DitroniX/EPEM-Ethernet-Power-Energy-Monitor/Code/README.md

# ** EPEM **

This folder contains Example Source Code and Information to help you develop and experiment, using the **EPEM Ethernet Power Energy Monitor** board.

  The purpose of the test code is to cycle through the various main functions of the board, as part of board bring up testing and product learning.
 
The **EPEM** is **ESP32-C6** based and the following examples/information should help you get started.

# FLEX and Home Assistant (ESPHome)

**FLEX** is PlatformIO code which tests and runs on either the EPEM ATM90E32 or EPEM ATM90E326.

[FLEX can be found here](https://github.com/DitroniX/EPEM-Ethernet-Power-Energy-Monitor/tree/main/Code/PlatformIO)

**Home Assistant (ESPHome)** support is also provided.

[Additional Home Assistant (ESPHome), component repository can be found here](https://github.com/DitroniX/Home-Assistant-Dev)

# Example Environments

## * **Arduino IDE**

The Arduino IDE does not auto detect and allows you to manually set the board

Set the BOARD to any **ESP32-C6**.  Example board options include:

 1. Adafruit Feather ESP32-C6
 2. DFRobot Beetle ESP32-C6

Arduino libraries specific for the code examples may need adding to your installation, as these are not automatically installed, unlike PlatformIO.

## * **PlatformIO**

When using PlatformIO code, the file *platformio.ini* should automatically load required libraries and configure board.   

The below example in *platfomio.ini* will configure the ESP32-C6.

	 - [env:esp32-c6-devkitm-1] 
	 - platform = espressif32 
	 - board = esp32-c6-devkitm-1 
	 - framework = arduino

Example PlatformIO will have the configuration set and libraries included, so this makes it easier.  Any libraries not installed, will automatically install.

## * **ESPHome**

In ESPHome you configure the board in the *yaml* code.

ESPHome unfortunately for some reason, does not list support for the ESP32-C6 within the code but it does work

In the later release of Home Assistant, this ESP32-C6 has native support.

The below example will configure the ESP32-C6.

	  - board: esp32-c6-devkitm-1
	  - flash_size: 4MB
	  - framework: type: esp-idf
	  - sdkconfig_options: CONFIG_ESPTOOLPY_FLASHSIZE_4MB: y

## * **Tasmota**

In Tasmota, you can:

	  -  set a template based on ESP32-C6

## * **MicroPython**

To flash, or program, a board in [MicroPython](https://micropython.org/download/ESP32_GENERIC_C6/), you will use the the esptool.py program. 

Details can be found [here] (https://docs.espressif.com/projects/esptool/en/latest/esp32c6/)

## * **LabVIEW**
This section is work in progress but with a focus on integrating the ESPuno Pi Zero, into the LabVIEW environment for training and experimenting.

The tutorial examples will be based on using LabVIEW Community Edition (which is free for non-commercial use).

## * **ThingSpeak**
[**ThingSpeak**](https://thingspeak.mathworks.com/) is a cloud base service.  It is free for small IoT Projects.

ThingSpeak (free version), offers up to four channels, each with 8 fields.   It is easy to setup and use, such as from IoT devices.

Data can be easily displayed on the web, mobile or tablets.  These consist of Graphs, Dials, Numeric and Lamp.

**Example Data**

Example output can be seen [here](https://thingspeak.mathworks.com/channels/2943970) 

Other Public Channels can be found [here](https://thingspeak.mathworks.com/channels/public)

# Flashing Speeds and Power

  - You may set the BAUD rate to 921600 to speed up flashing.
  - The SDK does NOT need external power to flash and will take Power from the USB 5V.

# Example Code

This test code is OPEN SOURCE and formatted for easier viewing.  

Although is is not intended for real world use, it may be freely used, or modified as needed to get your project up and running.

It is distributed on an "AS IS" BASIS, WITHOUT WARRANTIES OR CONDITIONS OF ANY KIND, either express or implied.

# **Further Information**

Additional information, and other technical details on this project, maybe found in the related repository pages.

**Repository Folders**

 - **Code** *(Code examples for Arduino  IDE, PlatformIO, ESPHome, Tasmota)*
 -  **Datasheets and Information** *(Component Datasheets, Schematics, Board Layouts, Photos, Technical Documentation)*
 - **Certification** *(Related Repository Project or Part, Certification Information)*

**Repository Tabs**

 - **Wiki** *(Related Repository Wiki pages and Technical User Information)*
 - **Discussions** *(Related Repository User Discussion Forum)*
 - **Issues** *(Related Repository Technical Issues and Fixes)*

***

We value our Customers, Users of our designs and STEM Communities, all over the World . Should you have any other questions, or feedback to share to others, please feel free to:

* Visit the related [Project](https://github.com/DitroniX?tab=repositories) *plus the related* **Discussions** and **Wiki** Pages.  See tab in each separate repository.
* **Project Community Information** can be found at https://www.hackster.io/DitroniX
* [DitroniX.net Website - Contact Us](https://ditronix.net/contact/)
* **Twitter**: [https://twitter.com/DitroniX](https://twitter.com/DitroniX)
* [Supporting the STEM Projects - BuyMeACoffee](https://www.buymeacoffee.com/DitroniX)
*  **LinkedIN**: [https://www.linkedin.com/in/g8puo/](https://www.linkedin.com/in/g8puo/)

***Dave Williams, Maidstone, UK.***

Electronics Engineer | Software Developer | R&D Support | RF Engineering | Product Certification and Testing | STEM Ambassador

## STEM

**Supporting [STEM Learning](https://www.stem.org.uk/)**

Life is one long exciting learning curve, help others by setting the seed to knowledge.
