DitroniX/EPEM-Ethernet-Power-Energy-Monitor/Datasheets and Information/README.md

**EPEM ESP32 ATM90E32 ATM90E36 Ethernet Power Energy Monitor SDK**

------------

This folder contains applicable datasheets and EPEM design information.

Further information can be found:

- **Website** https://ditronix.net/
- **WIKI**  https://ditronix.net/wiki/
- **GitHub**  https://github.com/DitroniX/

Dave Williams | G8PUO | DitroniX 1981-2025 | ditronix.net
