DitroniX/EPEM-Ethernet-Power-Energy-Monitor/Code/PlatformIO/README.md

**EPEM ESP32-C6 ATM90E36 Ethernet Power Energy Monitor SDK**

Please also see the [FLeX Test Code](https://github.com/DitroniX/FLEX-DitroniX-Power-Energy-Monitor-Firmware)

------------

This folder contains Example Source Code and Information to help you develop and experiment, using the EPEM Example Source Code.

For configuration information, please see README in root of the GitHub Code folder.
