DitroniX/EPEM-Ethernet-Power-Energy-Monitor/Certification/_CCAF25Y10610T3.pdf

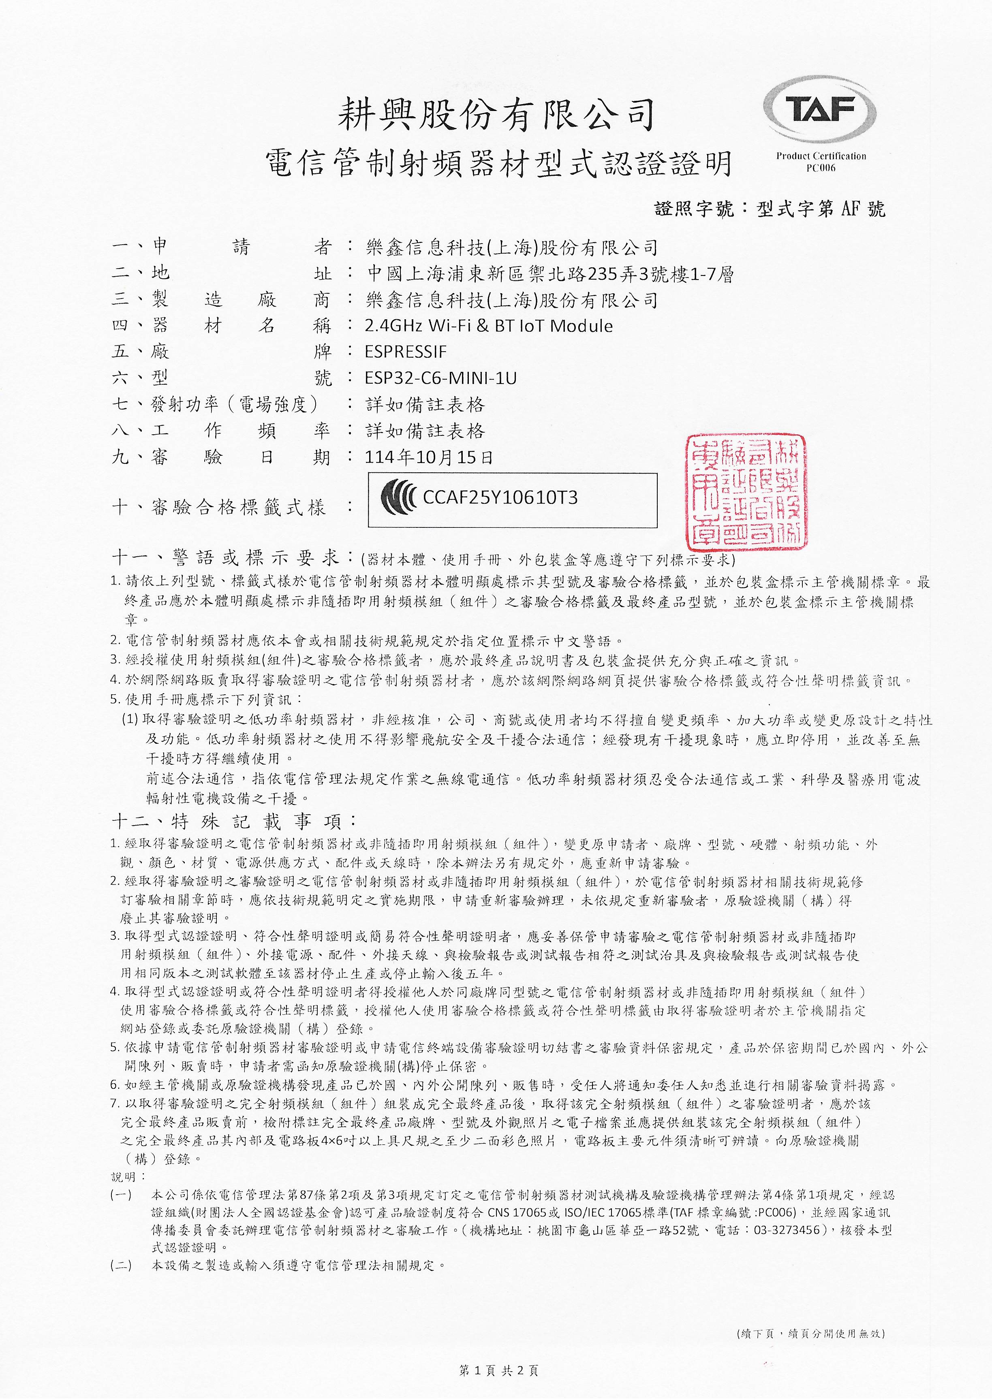
[picture p6: page 1]
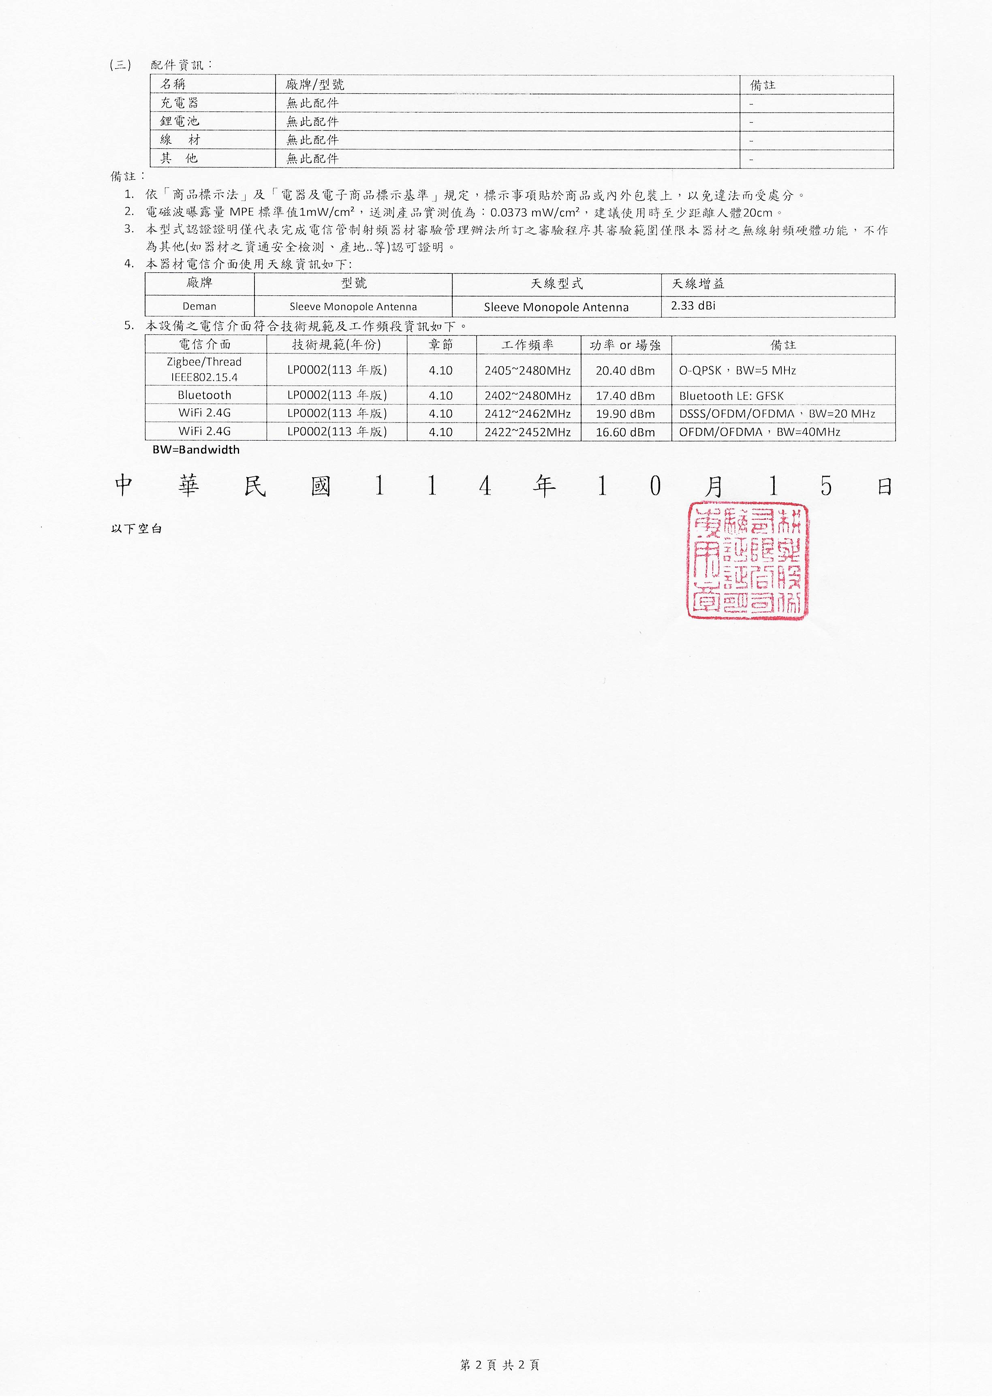
[picture p7: page 2]
