DitroniX/EPEM-Ethernet-Power-Energy-Monitor/Code/HomeAssistant-ESPHome/EPEM Ethernet Example/Screenshot.png

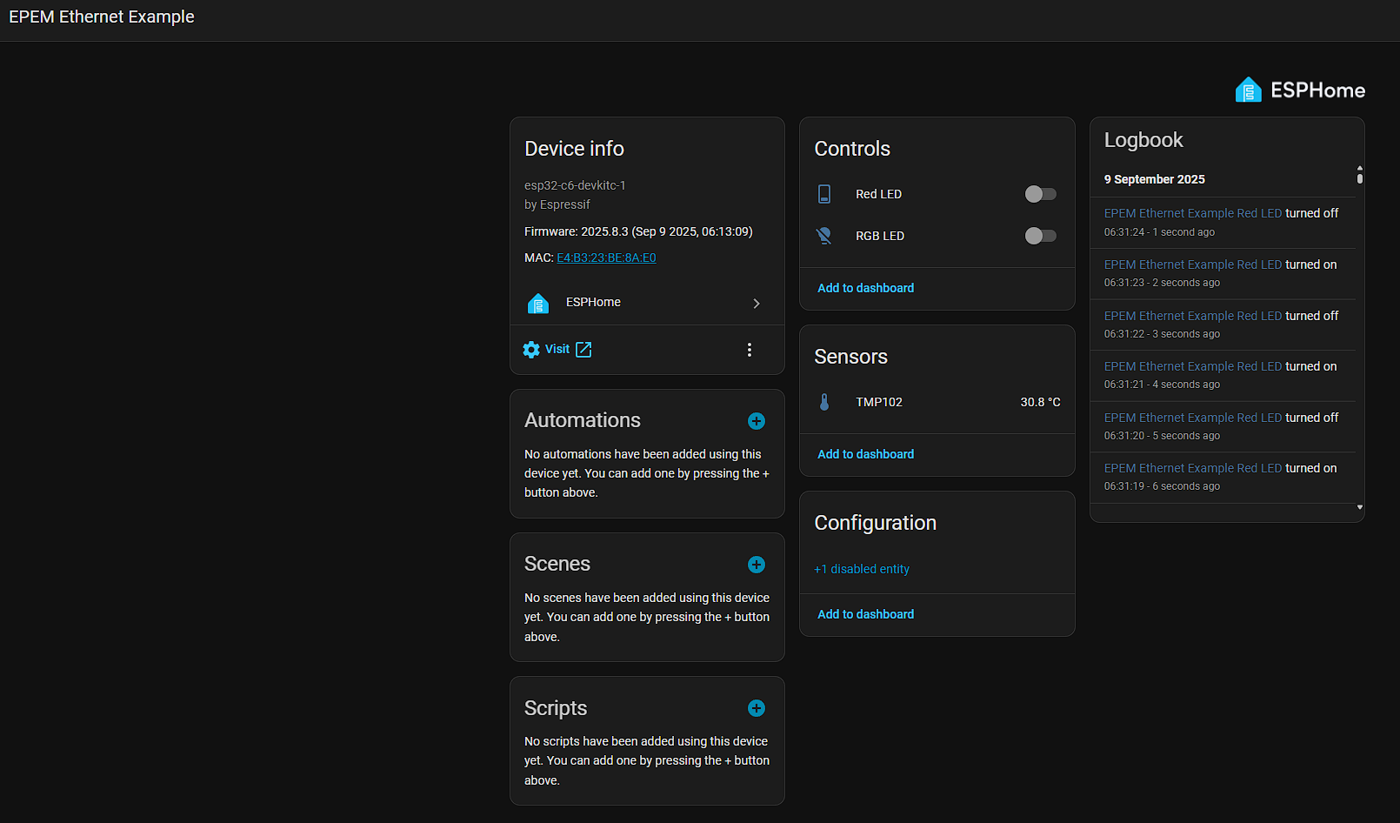
Code/HomeAssistant-ESPHome/EPEM Ethernet Example/Screenshot.png
