DitroniX/EPEM-Ethernet-Power-Energy-Monitor/Code/HomeAssistant-ESPHome/EPEM OLED Example/EPEM OLED.jpg

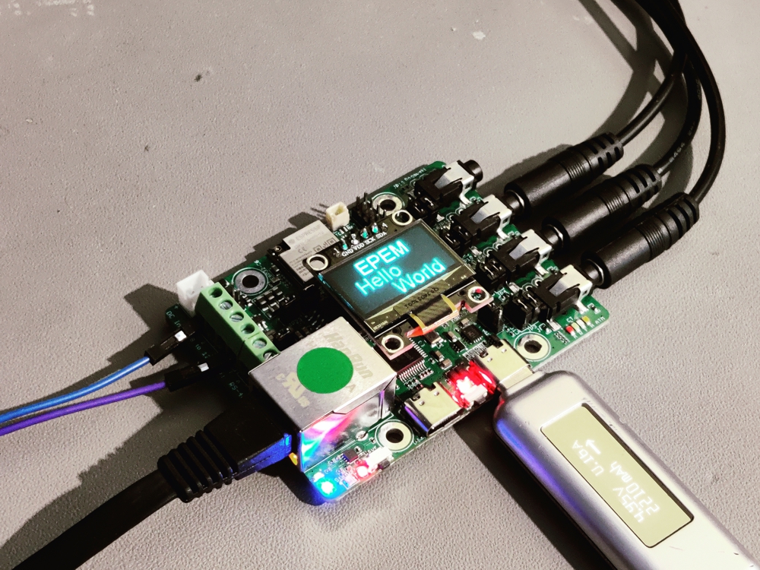
Code/HomeAssistant-ESPHome/EPEM OLED Example/EPEM OLED.jpg
