DitroniX/EPEM-Ethernet-Power-Energy-Monitor/Datasheets and Information/ATM90E32A Block Diagram.png

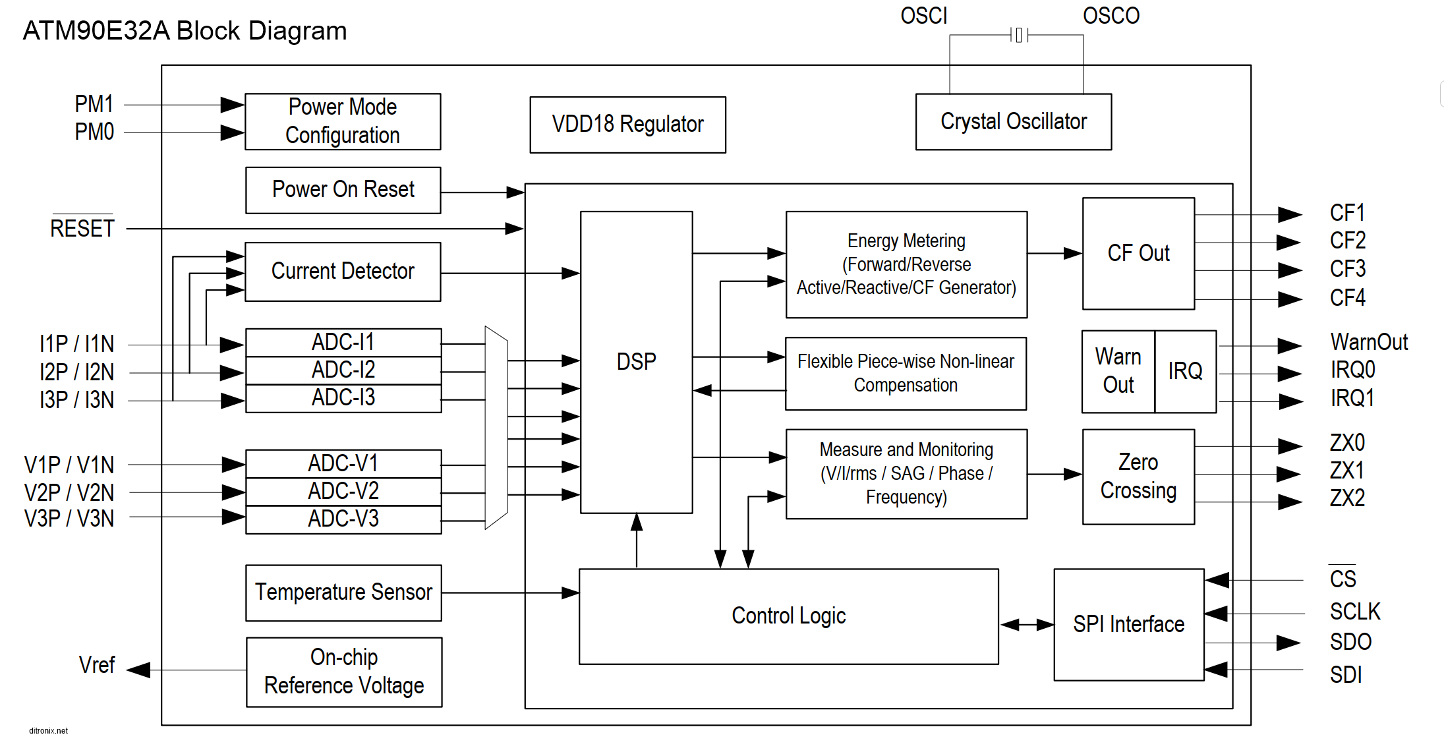
Datasheets and Information/ATM90E32A Block Diagram.png
