DitroniX/EPEM-Ethernet-Power-Energy-Monitor/Datasheets and Information/ATM90E36A Block Diagram.png

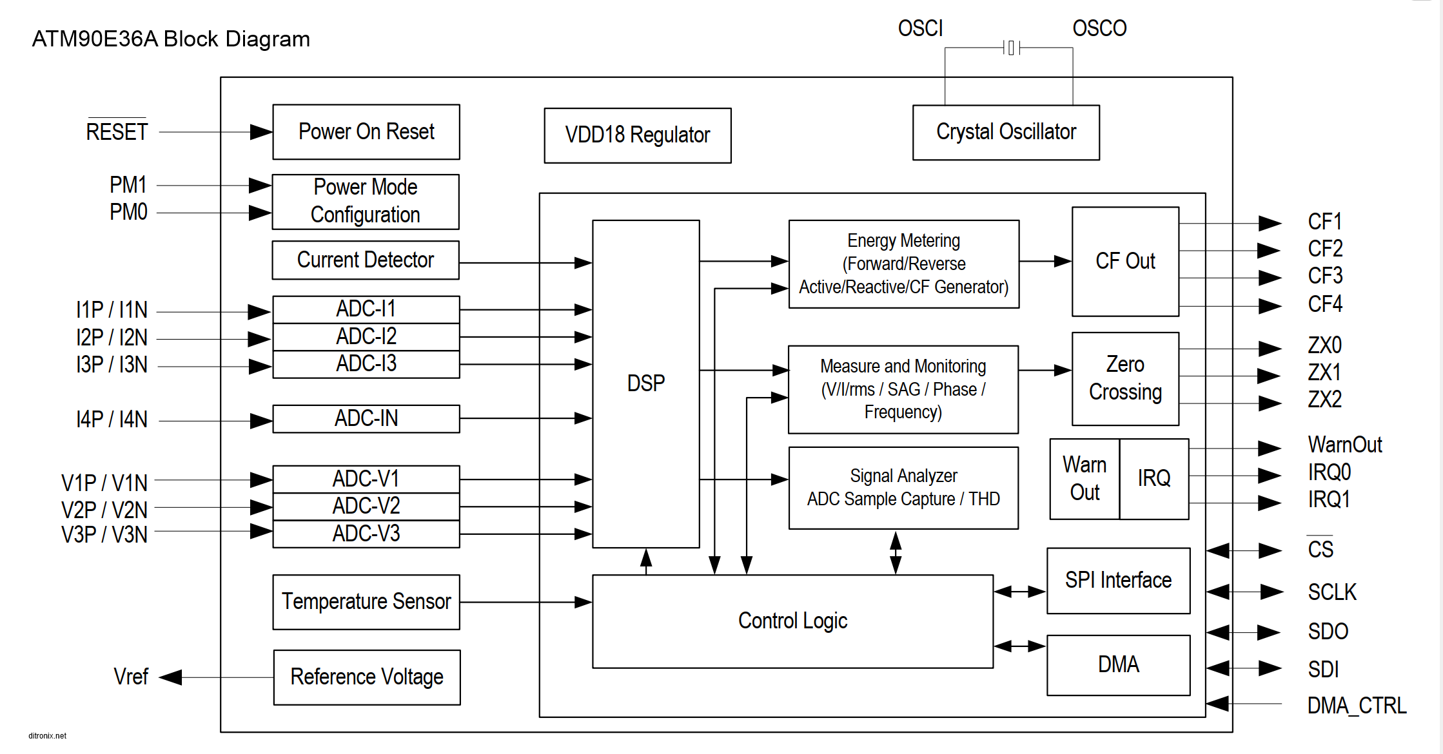
Datasheets and Information/ATM90E36A Block Diagram.png
