DitroniX/EPEM-Ethernet-Power-Energy-Monitor/Datasheets and Information/DitroniX.net EPEM Ethernet Power Energy Monitor Board SDK AC-CT Inputs.png

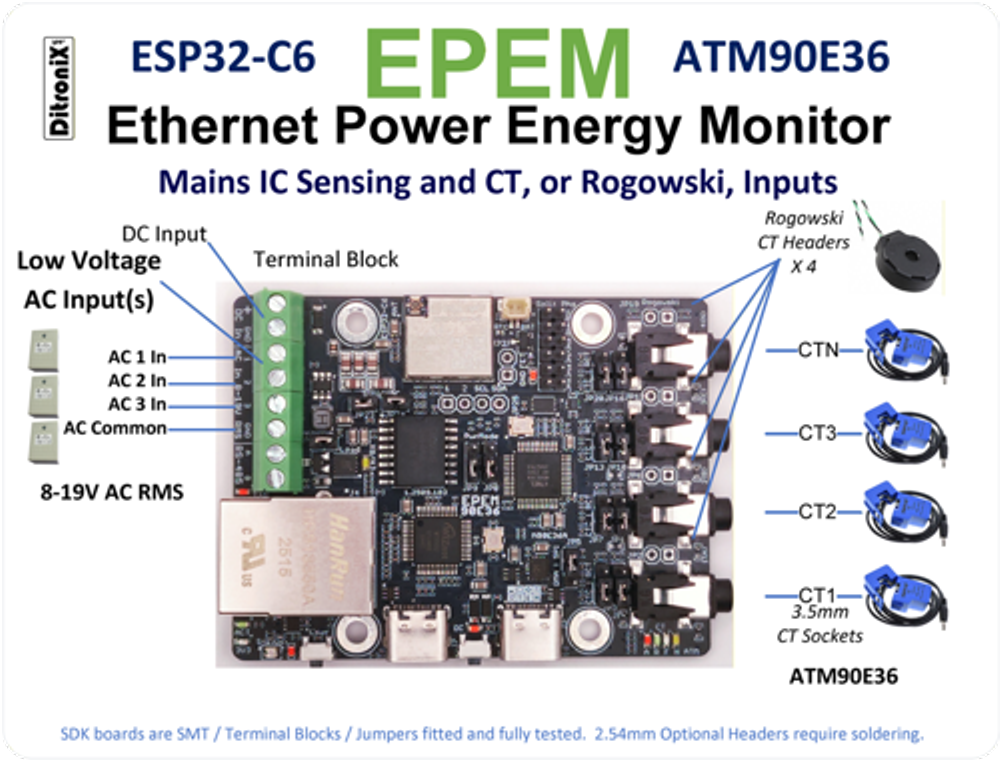
Datasheets and Information/DitroniX.net EPEM Ethernet Power Energy Monitor Board SDK AC-CT Inputs.png
