DitroniX/EPEM-Ethernet-Power-Energy-Monitor/Datasheets and Information/EPEM - Current Monitoring.png

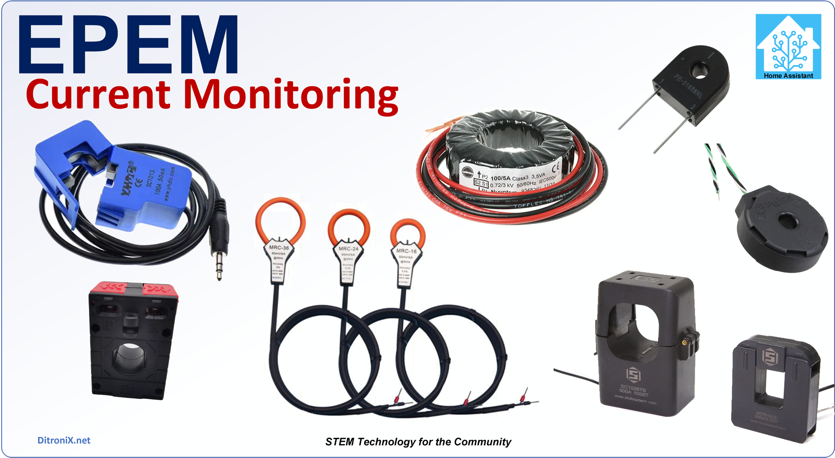
Datasheets and Information/EPEM - Current Monitoring.png
