DitroniX/EPEM-Ethernet-Power-Energy-Monitor/Datasheets and Information/EPEM AC Input.png

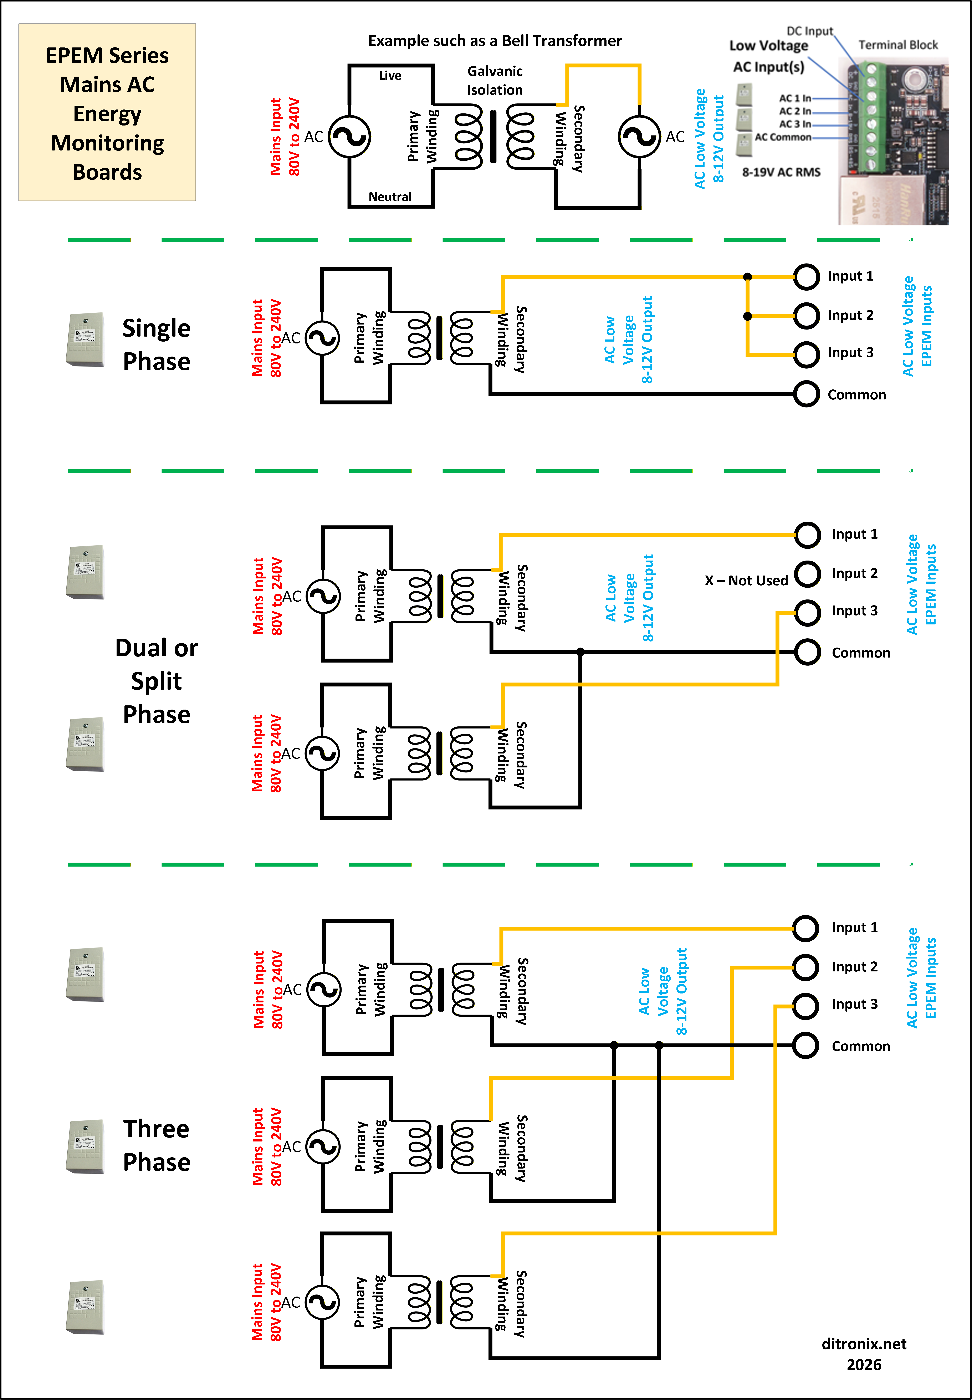
Datasheets and Information/EPEM AC Input.png
