DitroniX/EPEM-Ethernet-Power-Energy-Monitor/Datasheets and Information/EPEM ATM90E32 Beta Board (3).jpg

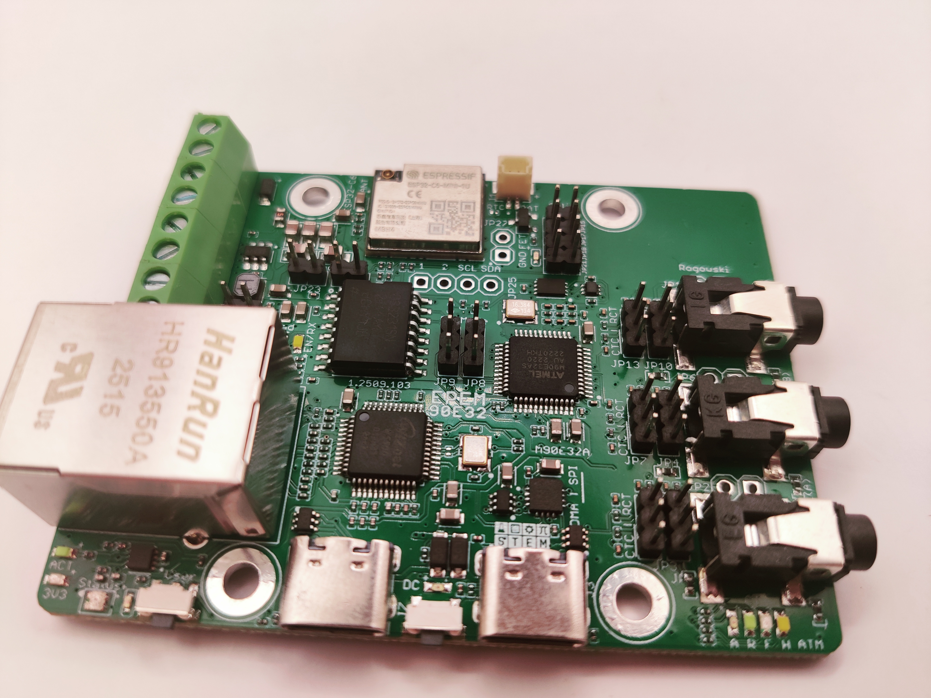
Datasheets and Information/EPEM ATM90E32 Beta Board (3).jpg
