DitroniX/EPEM-Ethernet-Power-Energy-Monitor/Datasheets and Information/EPEM ATM90E32 SDK (1).jpg

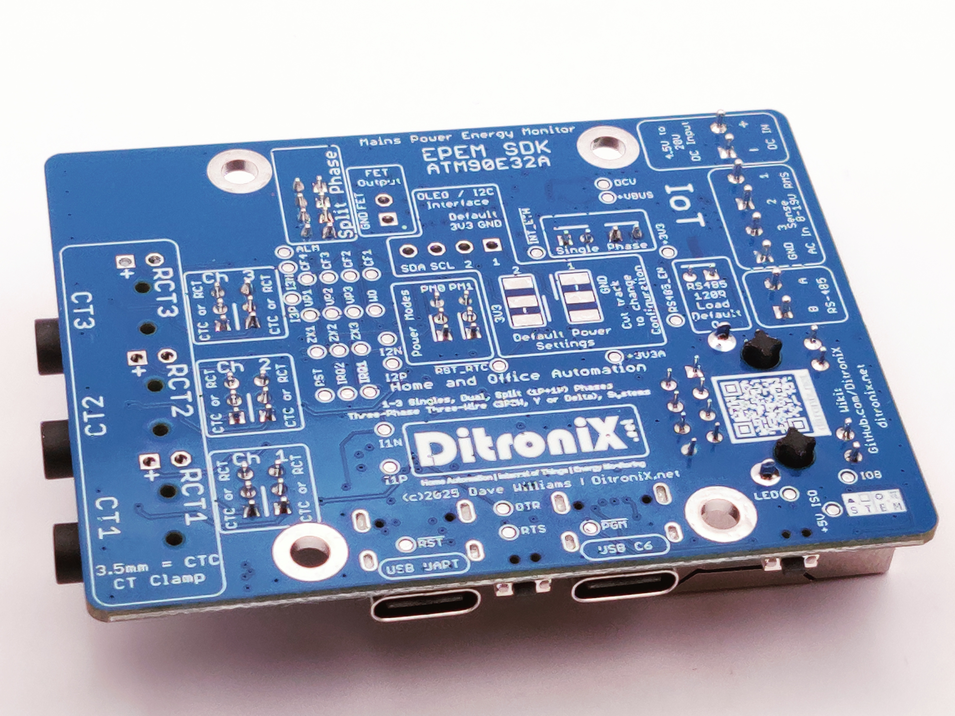
Datasheets and Information/EPEM ATM90E32 SDK (1).jpg
