DitroniX/EPEM-Ethernet-Power-Energy-Monitor/Datasheets and Information/EPEM E36 Packaged.jpg

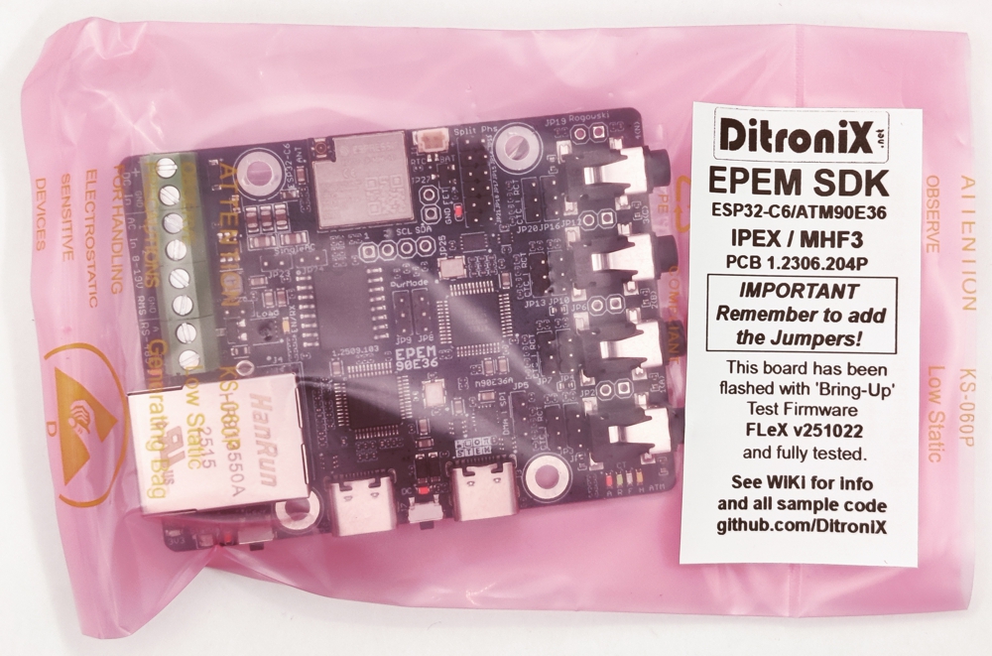
Datasheets and Information/EPEM E36 Packaged.jpg
