DitroniX/EPEM-Ethernet-Power-Energy-Monitor/Datasheets and Information/EPEM ESP32-C6 ATM90E36 Prototype Beta.jpg

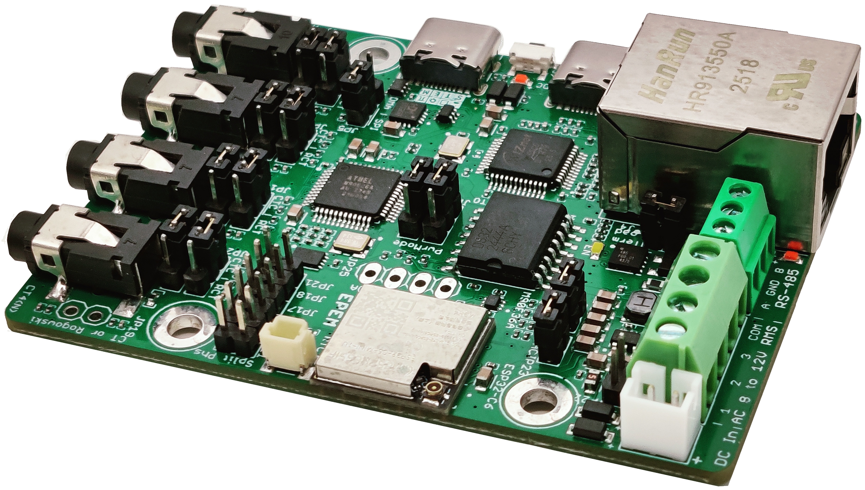
Datasheets and Information/EPEM ESP32-C6 ATM90E36 Prototype Beta.jpg
