DitroniX/EPEM-Ethernet-Power-Energy-Monitor/Datasheets and Information/EPEM Pin Matrix.png

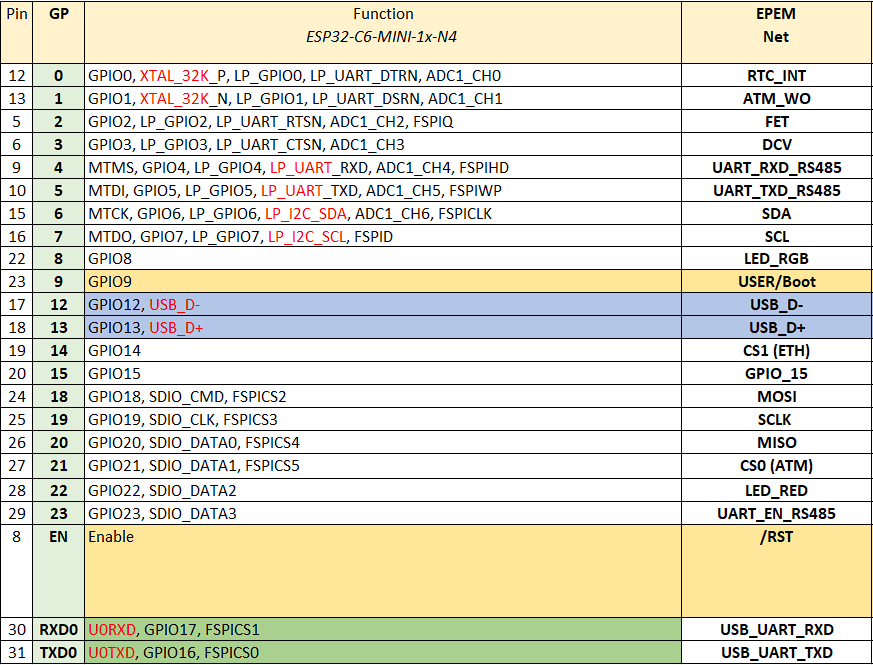
Datasheets and Information/EPEM Pin Matrix.png
