DitroniX/EPEM-Ethernet-Power-Energy-Monitor/Datasheets and Information/HA EPEM Dash Value Examples.png

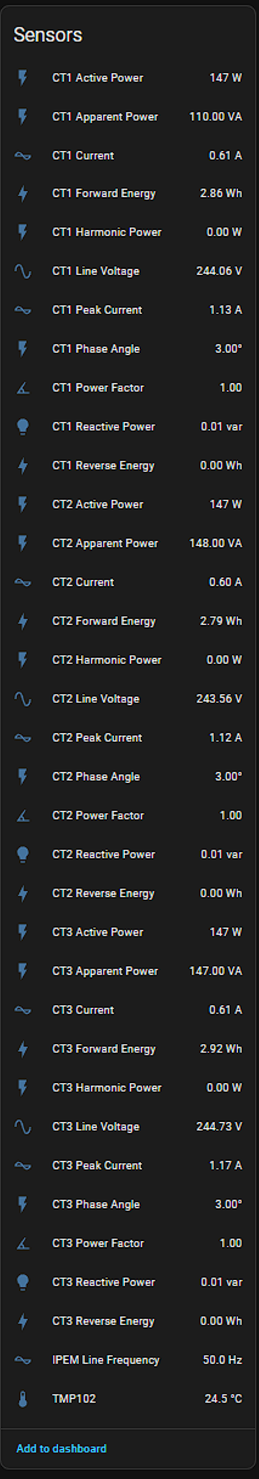
Datasheets and Information/HA EPEM Dash Value Examples.png
