DitroniX/EPEM-Ethernet-Power-Energy-Monitor/Datasheets and Information/Kickstarter - Now Live - EPEM.png

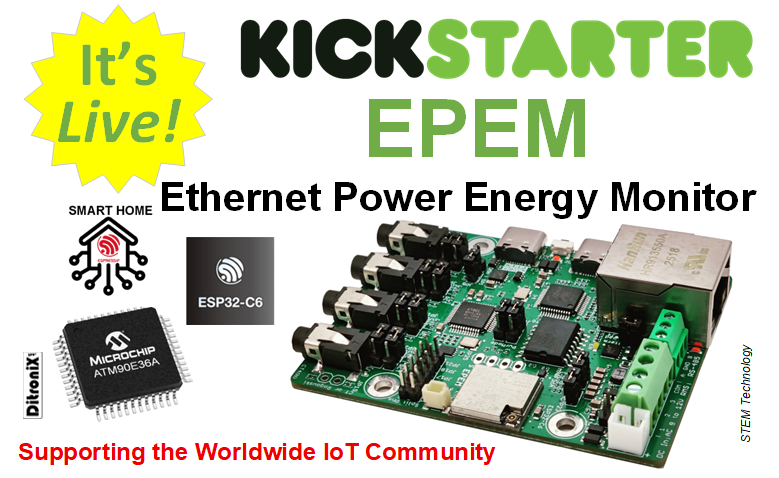
Datasheets and Information/Kickstarter - Now Live - EPEM.png
