DitroniX/EPEM-Ethernet-Power-Energy-Monitor/Datasheets and Information/PA3202NL Transformer Pulse Electronics.jpg

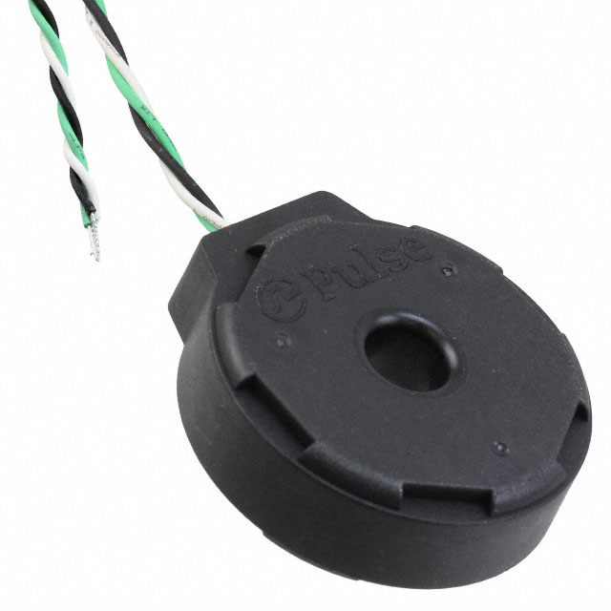
Datasheets and Information/PA3202NL Transformer Pulse Electronics.jpg
