DitroniX/EPEM-Ethernet-Power-Energy-Monitor/Datasheets and Information/Rogowski Current Transofrmer Coil.jpg

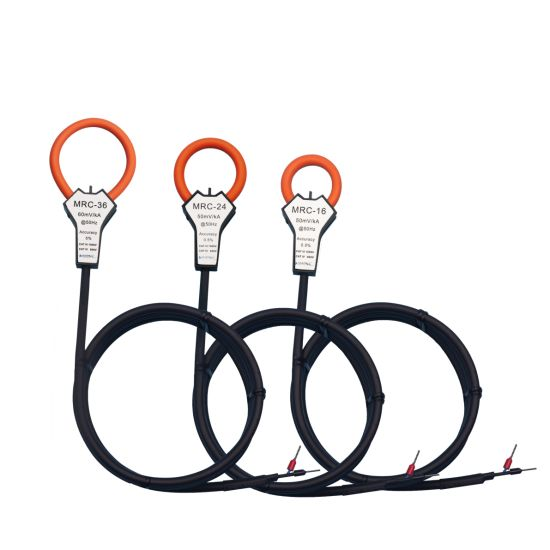
Datasheets and Information/Rogowski Current Transofrmer Coil.jpg
