DitroniX/EPEM-Ethernet-Power-Energy-Monitor/Datasheets and Information/YHDC SCT-013 100A-50mA.JPG

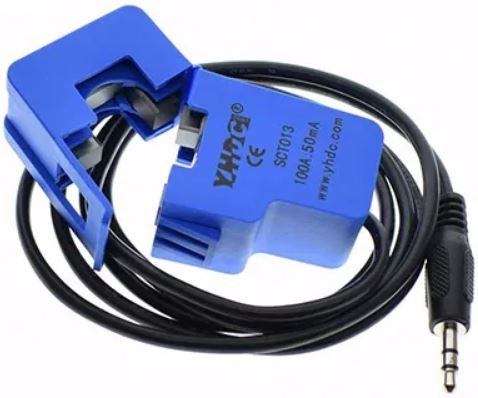
Datasheets and Information/YHDC SCT-013 100A-50mA.JPG
