DitroniX/EPEM-Ethernet-Power-Energy-Monitor/Code/PlatformIO/FLEX LITE Test Code for EPEM ATM90E36/Example Output E36.md

Note:   The load is a resistive 300W @ 248V AC input.  Using 3 x CT Clamps over the single phase mains cable.

===========

UART 1 Opened (RS485 Port)

FLEX Lite - Integrated Firmware for DitroniX Power Energy Monitor SDK Boards

Scanning and Configuring Board.. Please Wait..

Hardware Options and Auto Configuration
────────────────────────────────────────
Scanning I2C Bus for Devices for Auto Configuration ...
 I2C Possible Device(s) found at Address:
 * Hex 0x4A (74)         TMP102 Temperature Sensor
 * Hex 0x50 (80)         EEPROM
 * Hex 0x58 (88)         EEPROM
 * Hex 0x68 (104)        DS3231SN Accurate RTC
 I2C Bus Scan Complete

EPEM E36 IoT Power Energy Monitor Controller

EPEM E36 Register Status and Startup Report
ESP32-C6 Serial ID: F0FEFFBA2010
FLEX Lite for EPEM E36 Firmware Version: 260529
Board Location: Test

Wi-Fi Options
──────────────

Software Options
─────────────────
Connecting to the ATM90E36
====================================
ATM90E36 Connected - OK

EPEM E36 Hardware Setup and Power-Up Test - Board Initialized

EPEM E36 IoT Power Energy Monitor Controller

EPEM E36 Register Status and Startup Report
ESP32-C6 Serial ID: F0FEFFBA2010
FLEX Lite for EPEM E36 Firmware Version: 260529
Location: Test

Hardware Configuration for ATM90E36
────────────────────────────────────
AC Voltage Inputs:      Single Input V1 will be used for Current Phase Calculations
Split AC Voltage:       Dual  or Split Voltage Input Disabled
CT Current Clamps:      Configured for 1, 2, 3 Phase

[Status Values]
System Status:          S0:0xC0         S1:0x0
Meter Status:           E0:0x0          E1:0x0

Mains RMS Voltage
──────────────────
- - - - - - - - - - - - - - - - - - - - - - - - - - - 
Voltage 1: 245.28 V (Single Line Voltage Selected)

Mains RMS Current
──────────────────
Current CT1: 1.37 A
Current CT2: 1.38 A
Current CT3: 1.37 A
Current CTN: 4.12 A
- - - - - - - - - - - - - - - - - - - - - - - 
Actual Total Current: 4.12 A (CT1~CT2~CT3)

Calculated RMS Power
─────────────────────
Power V1*I1: 336.03 W   0.34 kW
Power V1*I2: 338.49 W   0.34 kW
Power V1*I3: 336.03 W   0.34 kW
Power V1*I4: 0.00 W
- - - - - - - - - - - - - - - - - - - - - - - - - 
Calculated Total Power: 1012.50 W (CT1~CT2~CT3)

Active Power (Absorbed or Used by the Load)
────────────────────────────────────────────
Active Power CT1: 0.34 kW       (Import)
Active Power CT2: 0.34 kW       (Import)
Active Power CT3: 0.34 kW       (Import)
- - - - - - - - - - - - - - - - - - - - 
Total Active Power: 0.67 kW     (Import)
- - - - - - - - - - - - - - - - - - - - - - - - - - - 
Calculated Total Active Power: 1.02 W (CT1~CT2~CT3)

Re-Active Power
────────────────
ReActive Power CT1: 0.00 VAR
ReActive Power CT2: 0.00 VAR
ReActive Power CT3: 0.00 VAR
- - - - - - - - - - - - - - - - - - - - - - - - 
Total ReActive Power: 0.04 VAR (CT1~CT2~CT3)
- - - - - - - - - - - - - - - - - - - - - - - - - - - - 
Calculated Total Reactive Power: 0.00 W (CT1~CT2~CT3)

Apparent Power (Total Amount of Power Flowing from Source to Load)
───────────────────────────────────────────────────────────────────
Apparent Power CT1: 0.34 VA
Apparent Power CT2: 0.34 VA
Apparent Power CT3: 0.34 VA
- - - - - - - - - - - - - - - - - - - - - - - 
Total Apparent Power: 0.67 VA (CT1~CT2~CT3)
- - - - - - - - - - - - - - - - - - - - - - - - - - - - - 
Calculated Total Apparent Power: 1.02 VA (CT1~CT2~CT3)

Power Factor
─────────────
Power Factor CT1: 1.00 PF
Power Factor CT2: 1.00 PF
Power Factor CT3: 1.00 PF
- - - - - - - - - - - - - - - 
Total Power Factor: 1.00 PF

Phase Angle
────────────
Phase Angle CT1: 3.40
Phase Angle CT2: 3.30
Phase Angle CT3: 3.00

Voltage Harmonics
──────────────────
Voltage Harmonics CT1: 0.00
Voltage Harmonics CT2: 0.00
Voltage Harmonics CT3: 0.00

Current Harmonics
──────────────────
Current Harmonics CT1: 0.00
Current Harmonics CT2: 0.00
Current Harmonics CT3: 0.00

Other Information
──────────────────
Chip Temperature: 28.00 °C

Mains Frequency: 50.11 Hz

ADC Raw: 47 > ADC Adjusted: 47 > Calculated: 4.91 V DC
