DitroniX/EPEM-Ethernet-Power-Energy-Monitor/Datasheets and Information/EPEM Testing Settings.jpg

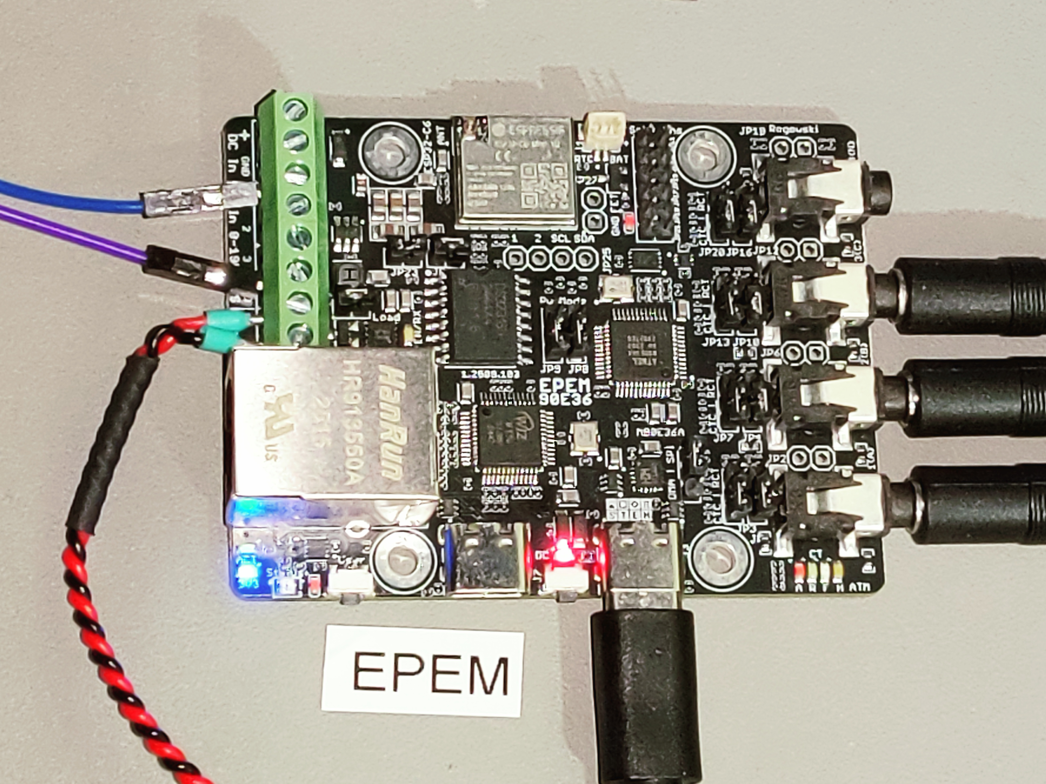
Datasheets and Information/EPEM Testing Settings.jpg
