DitroniX/EPEM-Ethernet-Power-Energy-Monitor/Datasheets and Information/EPEM Testing.jpg

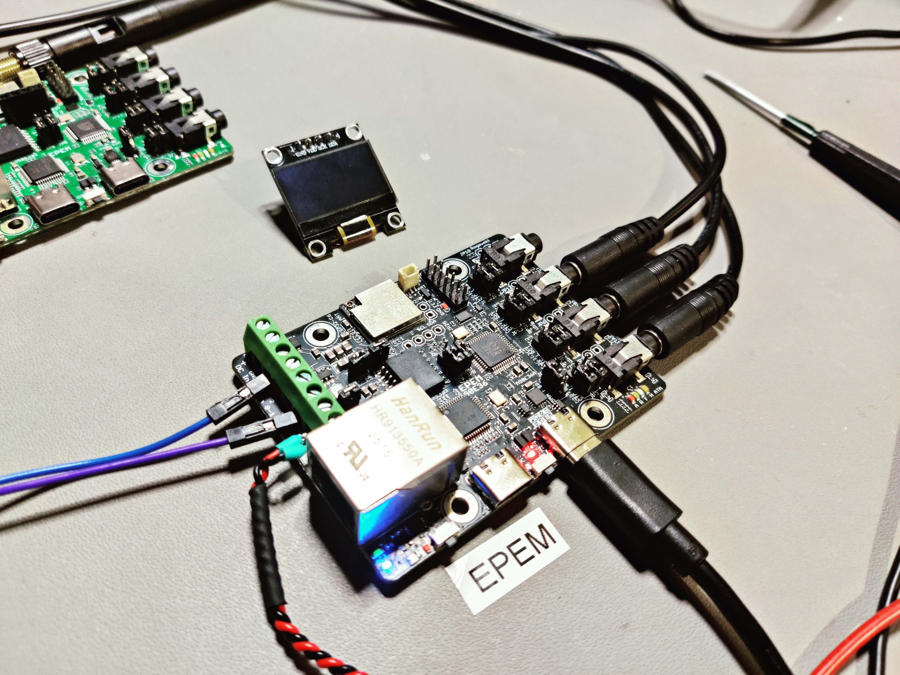
Datasheets and Information/EPEM Testing.jpg
