DitroniX/EPEM-Ethernet-Power-Energy-Monitor/Datasheets and Information/HA EPEM Dash Test.png

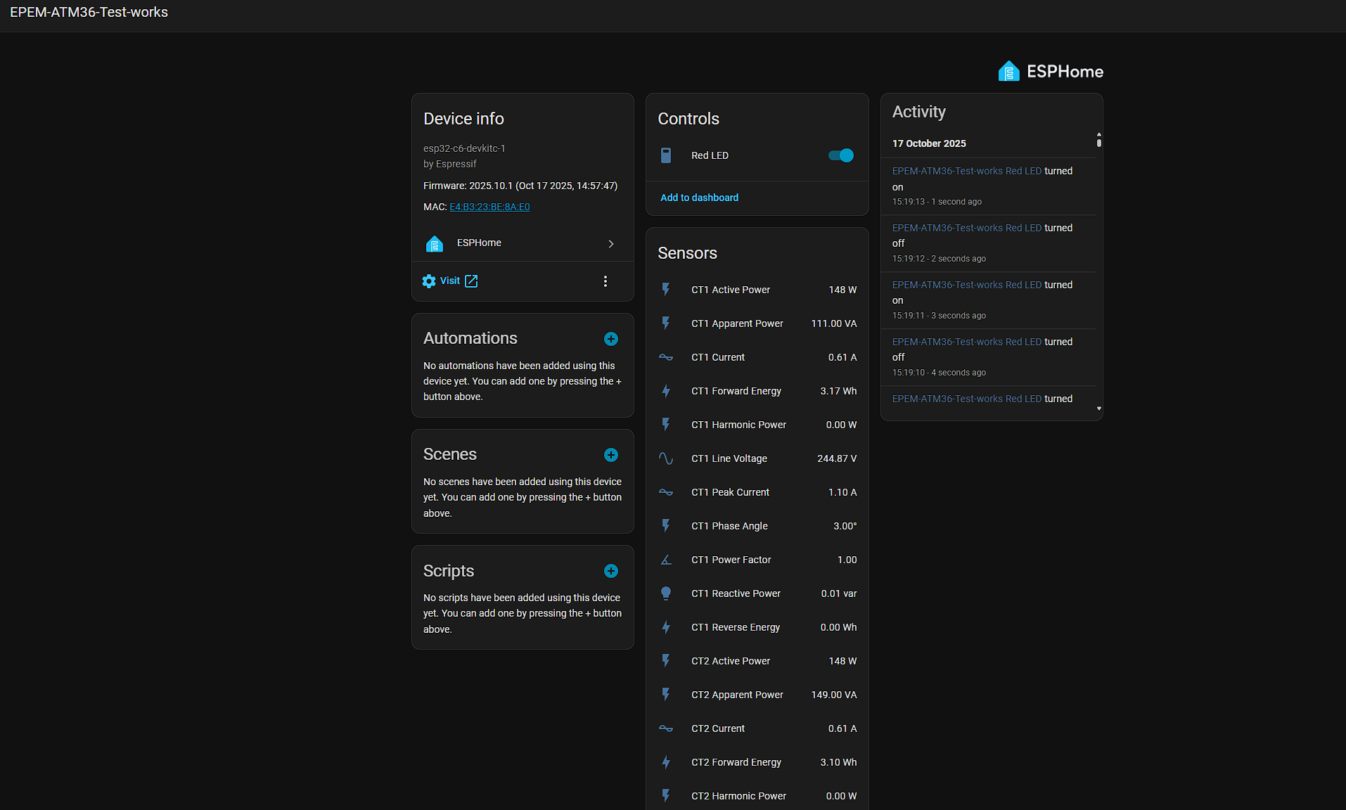
Datasheets and Information/HA EPEM Dash Test.png
