DitroniX/EPEM-Ethernet-Power-Energy-Monitor/Code/ArduinoIDE/DS3231_Test/DS3231_Test.ino

/*
  Dave Williams, DitroniX 2019-2025 (ditronix.net)

  Example Code, to demonstrate and test the ESPuno Pi Zero with IPEM PiHat, DS3231 RTC Basic Test

  Further information, details and examples can be found on our website and also GitHub wiki pages:
  * ditronix.net
  * github.com/DitroniX
  * github.com/DitroniX/ESPuno-Pi-Zero_WiFi-BT-Zigbee-Thread-60V
  * github.com/DitroniX/ESPuno-Pi-Zero_WiFi-BT-Zigbee-Thread-60V/wiki
  * hackster.io/DitroniX/espuno-pi-zero-wifi-bt-zigbee-thread-60v-69ef92
  * kickstarter.com/projects/ditronix/espuno-pi-zero

  This test code is OPEN SOURCE and formatted for easier viewing.  Although is is not intended for real world use, it may be freely used, or modified as needed.
  It is distributed on an "AS IS" BASIS, WITHOUT WARRANTIES OR CONDITIONS OF ANY KIND, either express or implied.

  For board configuration, see https://github.com/DitroniX/ESPuno-Pi-Zero_WiFi-BT-Zigbee-Thread-60V/wiki/Arduino-IDE

  Further information, details and examples can be found on our website wiki pages ditronix.net/wiki and also github.com/DitroniX
*/

// Libraries
#include <DS3231.h>
#include <Wire.h>

// **************** USER VARIABLES / DEFINES / STATIC / STRUCTURES / CONSTANTS ****************

// Hardware Serial 0 GPIO Pins
#define RXD0 17
#define TXD0 16

// Define I2C (Expansion Port)
#define I2C_SDA 6
#define I2C_SCL 7
#define I2C_CLOCK 4000000UL

char myData[50];
DS3231 myRTC;
bool h12Flag;
bool pmFlag;

// **************** FUNCTIONS AND ROUTINES ****************

// **************** SETUP ****************
void setup() {
  // Stabalise
  delay(250);

  // Initialise UART
  Serial.begin(115200, SERIAL_8N1, RXD0, TXD0);  // U0
  while (!Serial)
    ;
  Serial.println("");

  // Initialize I2C
  Wire.begin(I2C_SDA, I2C_SCL);

  Serial.println("ESPuno Pi Zero and IPEM PiHat - Example Code");
}

// **************** LOOP ****************
void loop() {

  Serial.println("Serial U0");

  // Finally the hour, minute, and second
  Serial.print(myRTC.getHour(h12Flag, pmFlag), DEC);
  Serial.print(" ");
  Serial.print(myRTC.getMinute(), DEC);
  Serial.print(" ");
  Serial.print(myRTC.getSecond(), DEC);

  // Display the temperature
  Serial.print("\tT=");
  Serial.println(myRTC.getTemperature(), 2);

  delay(500);
}
