DitroniX/EPEM-Ethernet-Power-Energy-Monitor/(commit log)

2023-08-05 Power Energy Monitor Boards SDK Overview
2025-07-31 EPEM ESP32-C6 ATM90E36 Prototype Beta
2025-07-31 EPEM Example Code Arduino
2025-08-02 EPEM Ethernet Power Energy Monitor Board Overview
2025-08-23 EPEM ATM90E32 ATM90E36 Registers
    [EPEM ATM90E32 ATM90E36 Registers.xlsx]
2025-10-01 Create EPEM Pin Matrix.png
2026-02-23 Create DitroniX.net EPEM Ethernet Power Energy Monitor Board SDK AC-CT Inputs.png
2026-02-23 Update DitroniX.net EPEM Ethernet Power Energy Monitor Board SDK AC-CT Inputs.png
2026-03-19 Create EPEM Power Energy Monitor.png
2026-03-27 Create EPEM - Current Monitoring.png
2026-04-11 Update EPEM - Ethernet Power Energy Monitor Preview.png
2026-04-11 Update EPEM Power Energy Monitor.png
